YIGOSA2/Moxibustion/屏幕工程/HMI2.png

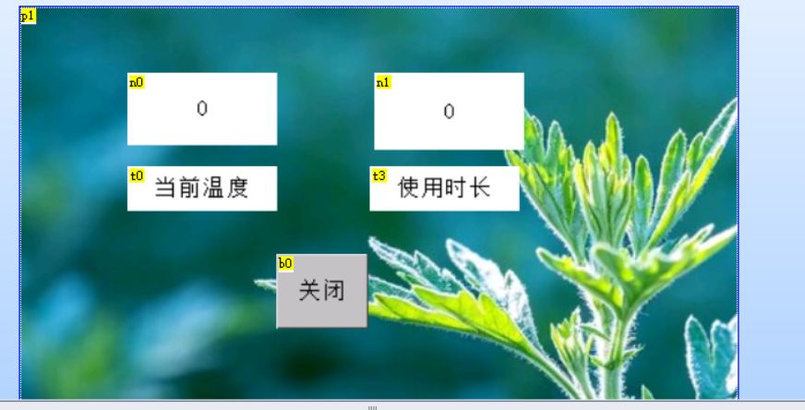
屏幕工程/HMI2.png
