YIGOSA2/Moxibustion/原理图/schematic_page-1.png

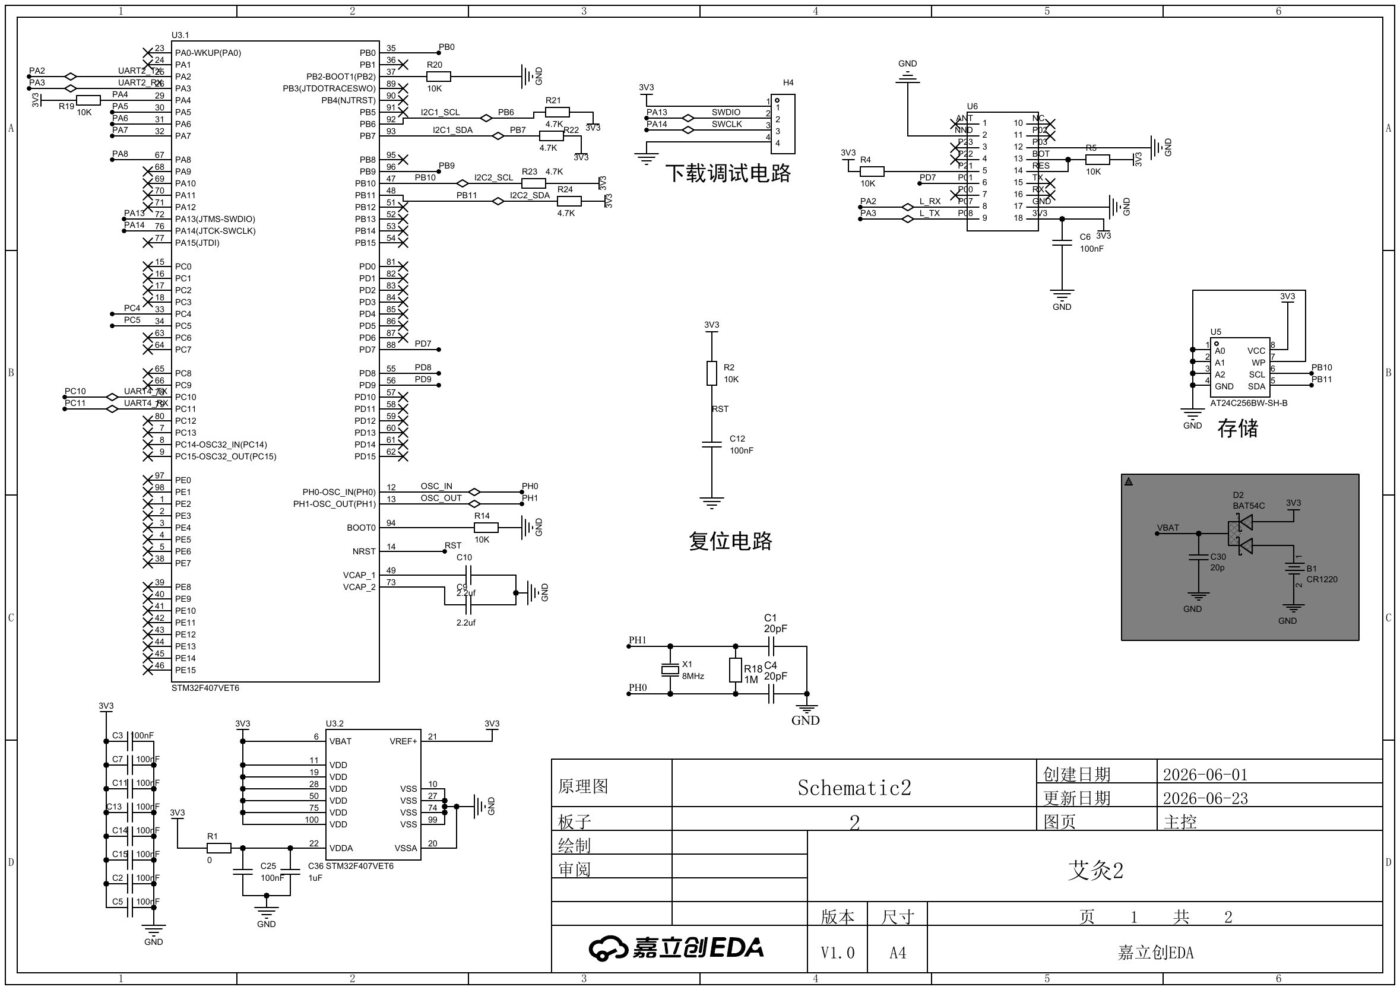
原理图/schematic_page-1.png
