YIGOSA2/Moxibustion/原理图/schematic_page-2.png

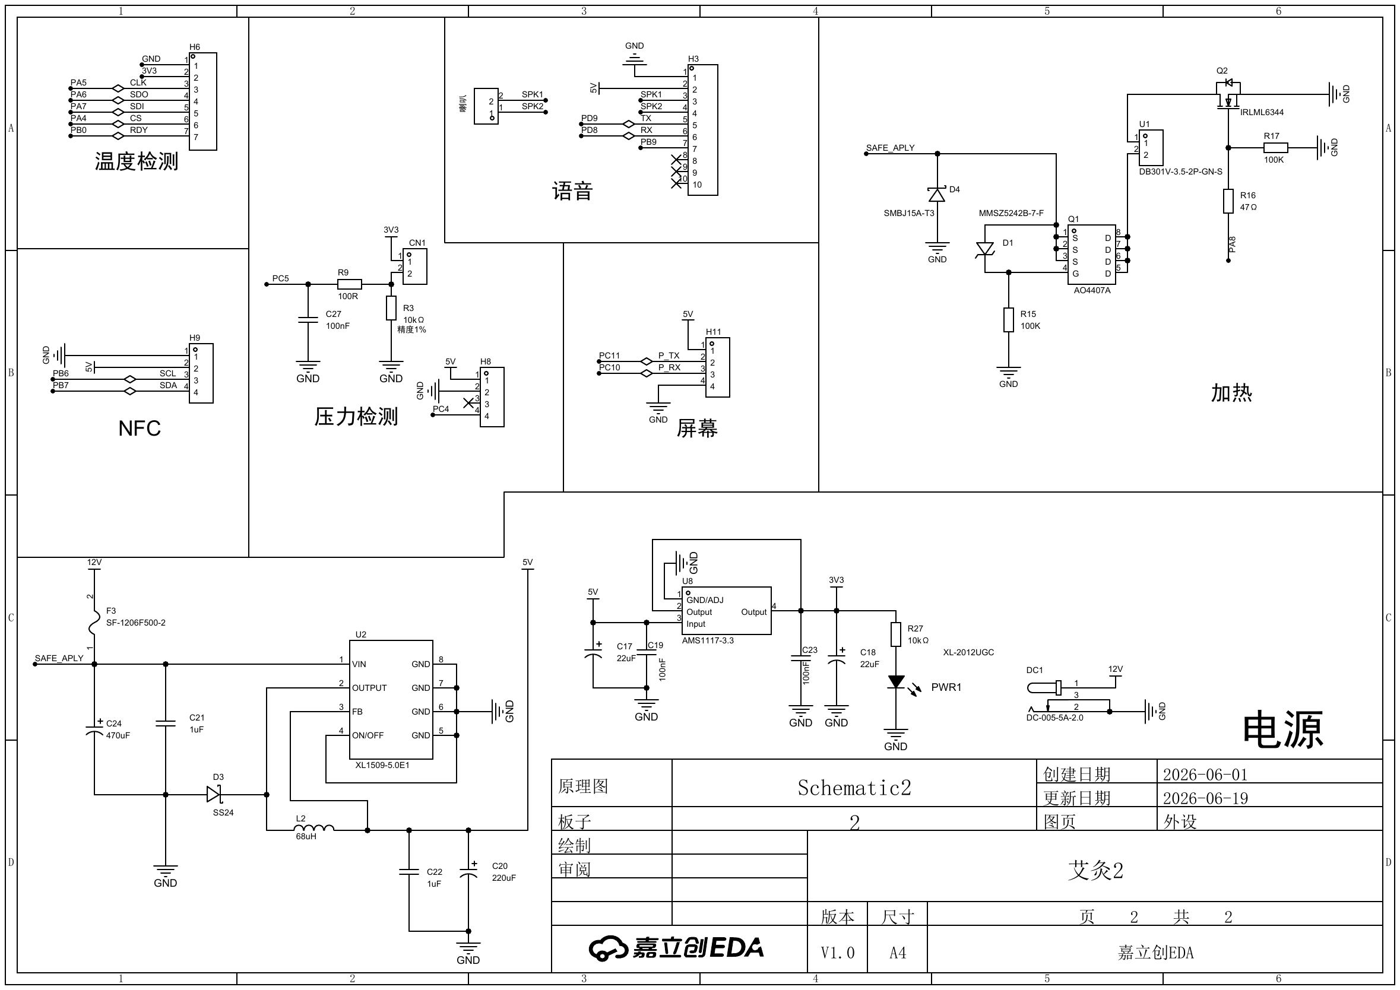
原理图/schematic_page-2.png
