YIGOSA2/Moxibustion/屏幕工程/HMI1.png

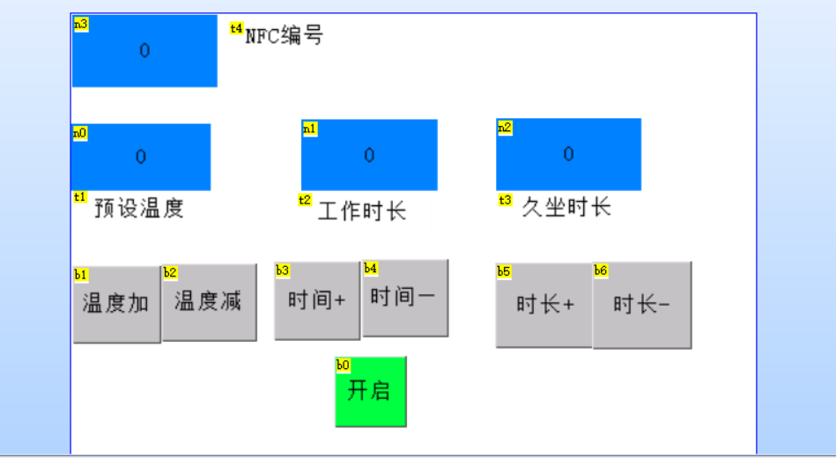
屏幕工程/HMI1.png
