YIGOSA2/Moxibustion/原理图/嵌赛原理图.pdf

# 下载调试电路

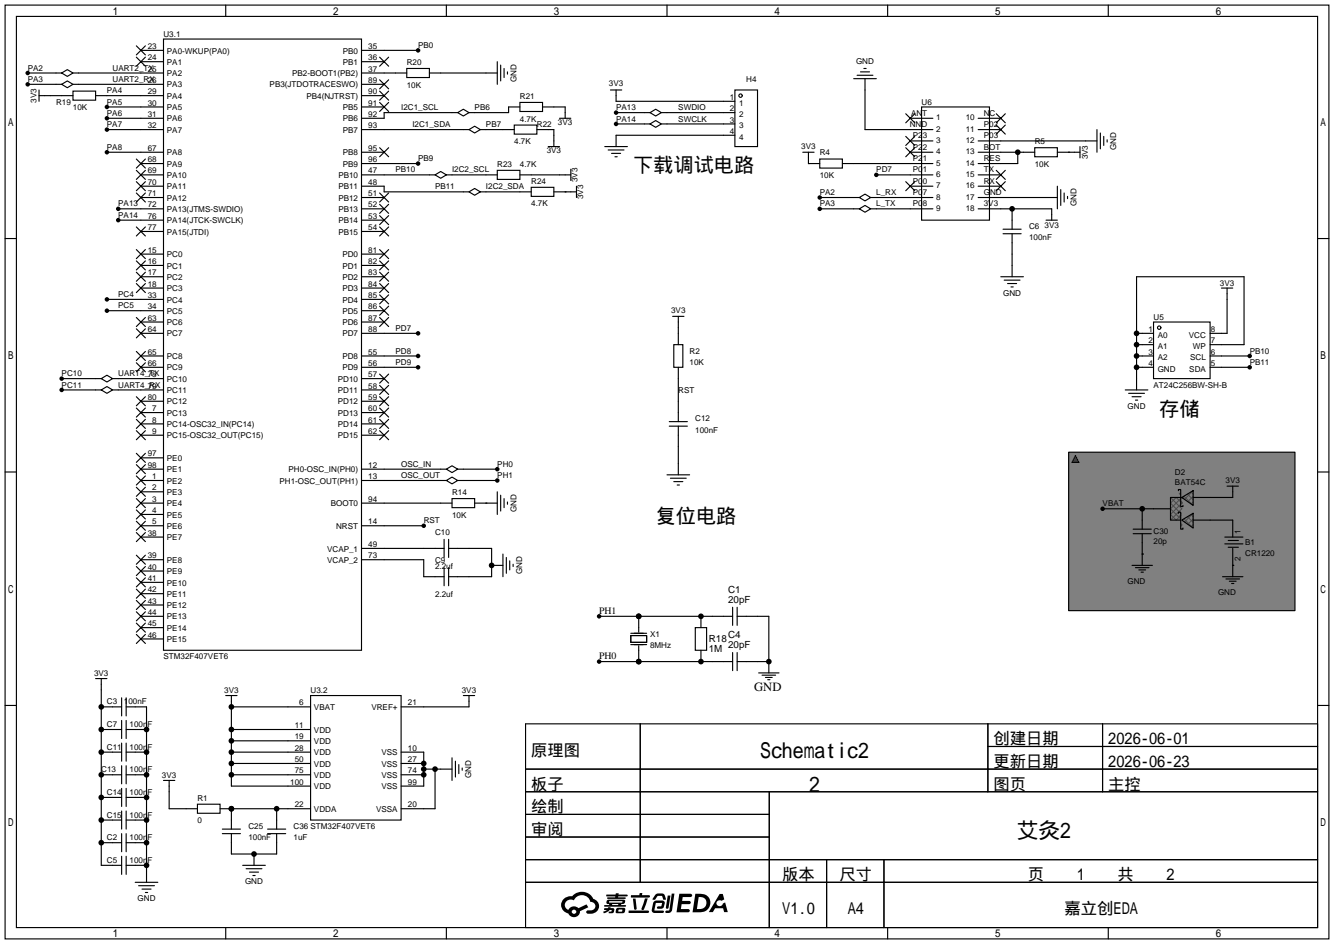
[picture p5: page 1]

原理图 | Schematic2 | 创建日期 | 2026-06-01

更新日期 | 2026-06-23

板子 | | 图页 | 主控
绘制 | | 艾灸2
审阅

V1.0 | A4 | 嘉立创EDA

板子 | 图页 | 外设 ⁵V

# 温度检测

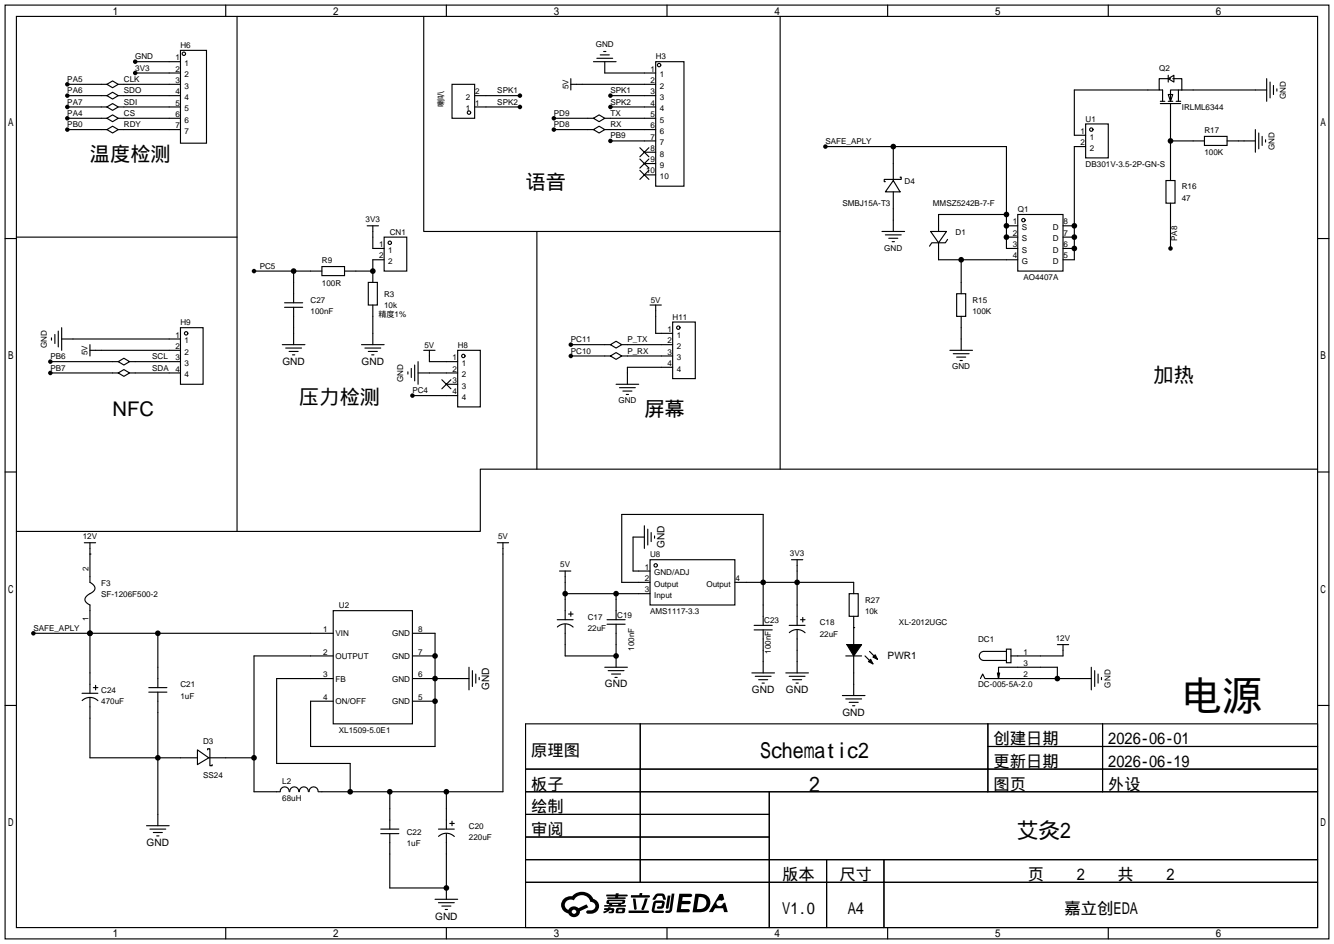
[picture p6: page 2]

原理图 | Schematic2 | 创建日期 | 2026-06-01

更新日期 | 2026-06-19

绘制 | 艾灸2
审阅

V1.0 | A4 | 嘉立创EDA
