YIGOSA2/Moxibustion/NFC01.ioc

Mcu.UserName=STM32F407ZETx
PA13.Signal=SYS_JTMS-SWDIO
PA14.Signal=SYS_JTCK-SWCLK
PA2.Signal=USART2_TX
PA3.Signal=USART2_RX
PA4.Signal=GPIO_Output
PA5.Signal=SPI1_SCK
PA6.Signal=SPI1_MISO
PA7.Signal=SPI1_MOSI
PA8.Signal=GPIO_Output
PB0.Signal=GPIO_Input
PB10.Signal=I2C2_SCL
PB11.Signal=I2C2_SDA
PB6.Signal=I2C1_SCL
PB7.Signal=I2C1_SDA
PC10.Signal=UART4_TX
PC11.Signal=UART4_RX
PC5.Signal=ADCx_IN15
PD8.Signal=USART3_TX
PD9.Signal=USART3_RX
PH0-OSC_IN.Signal=RCC_OSC_IN
PH1-OSC_OUT.Signal=RCC_OSC_OUT
